betamoojw/LED-UP1-6x24V/hardware/EDA-Files/LED-UP1-4x24V/LED-UP1-4x24V.kicad_pcb

## KiCad design hardware/EDA-Files/LED-UP1-4x24V/LED-UP1-4x24V.kicad_pcb (2024-03-28)

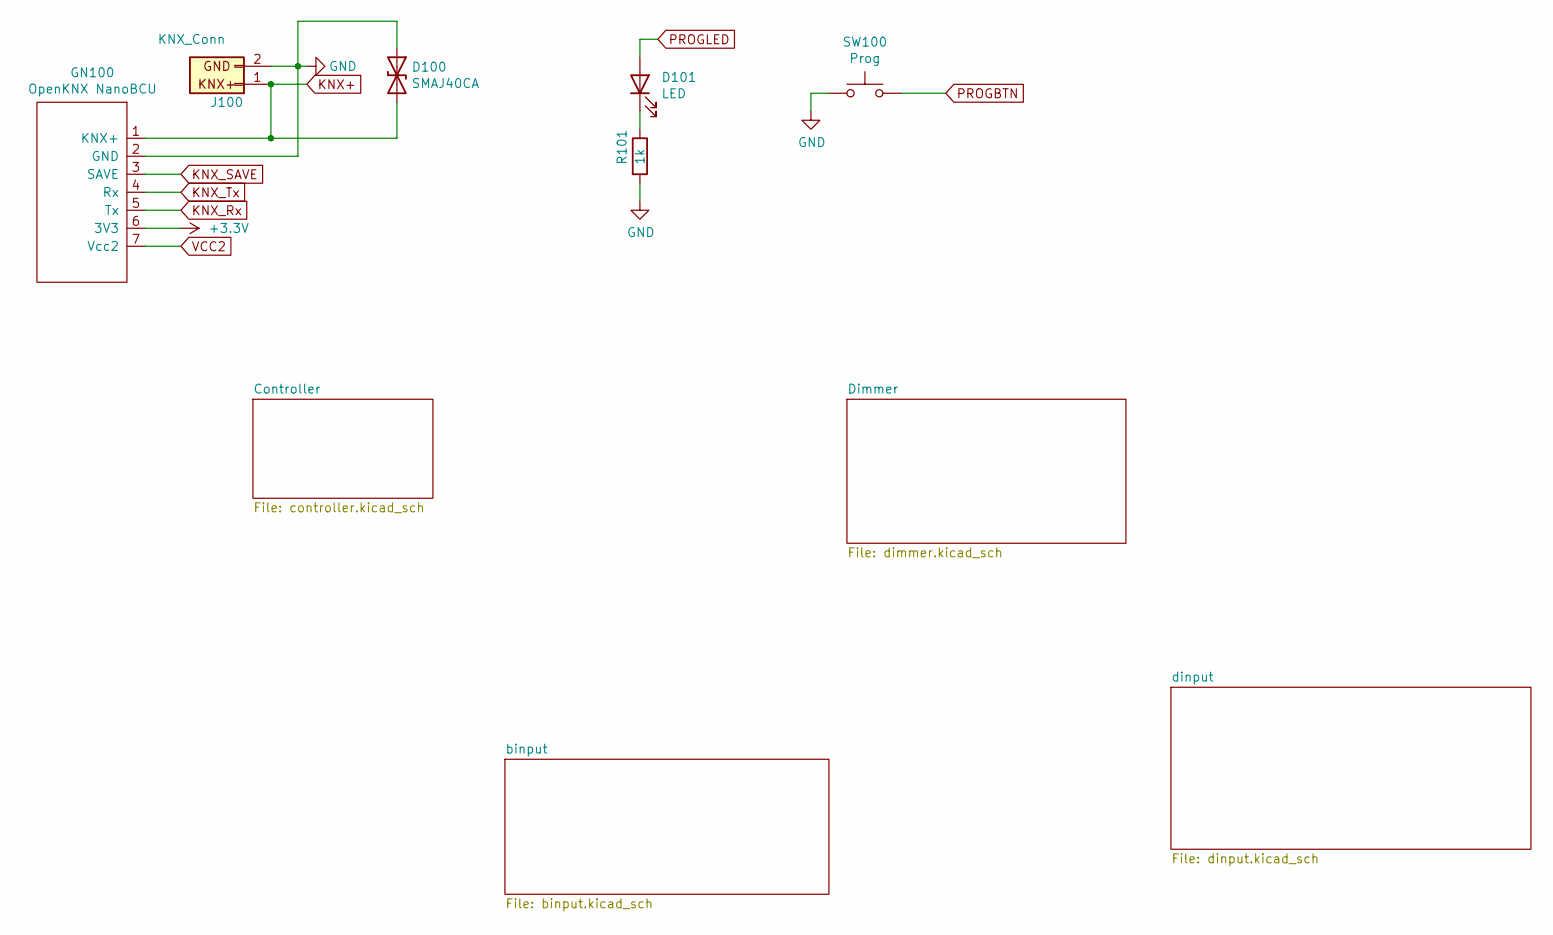
[picture p1: schematic LED-UP1-4x24V.kicad_sch]

Parts:
D100: SMAJ40CA; D_SMA; LCSC C113970
D101: LED; LED_0603_1608Metric; LCSC C2286
GN100: OpenKNX NanoBCU; NanoBCU_PinHeader_SMD_low_profile; LCSC C5160790
J100: KNX_Conn; KNX_Connector
R101: 1k; R_0402_1005Metric; LCSC C11702
SW100: Prog; C455282_SW-SMD_4P-L4.2-W3.3-P2.15-LS5.1; LCSC C455282

Connections:
+3.3V: GN100.6 (3V3); also elsewhere on the board
GND: D100.1 (A1), GN100.2 (GND), J100.2, R101.2, SW100.1; also elsewhere on the board
KNX+: D100.2 (A2), GN100.1 (KNX+), J100.1
KNX_Rx: GN100.5 (Tx); also elsewhere on the board
KNX_SAVE: GN100.3 (SAVE); also elsewhere on the board
KNX_Tx: GN100.4 (Rx); also elsewhere on the board
unnamed: D101.1 (K), R101.1
PROGBTN: SW100.2; also elsewhere on the board
PROGLED: D101.2 (A); also elsewhere on the board
VCC2: GN100.7 (Vcc2)

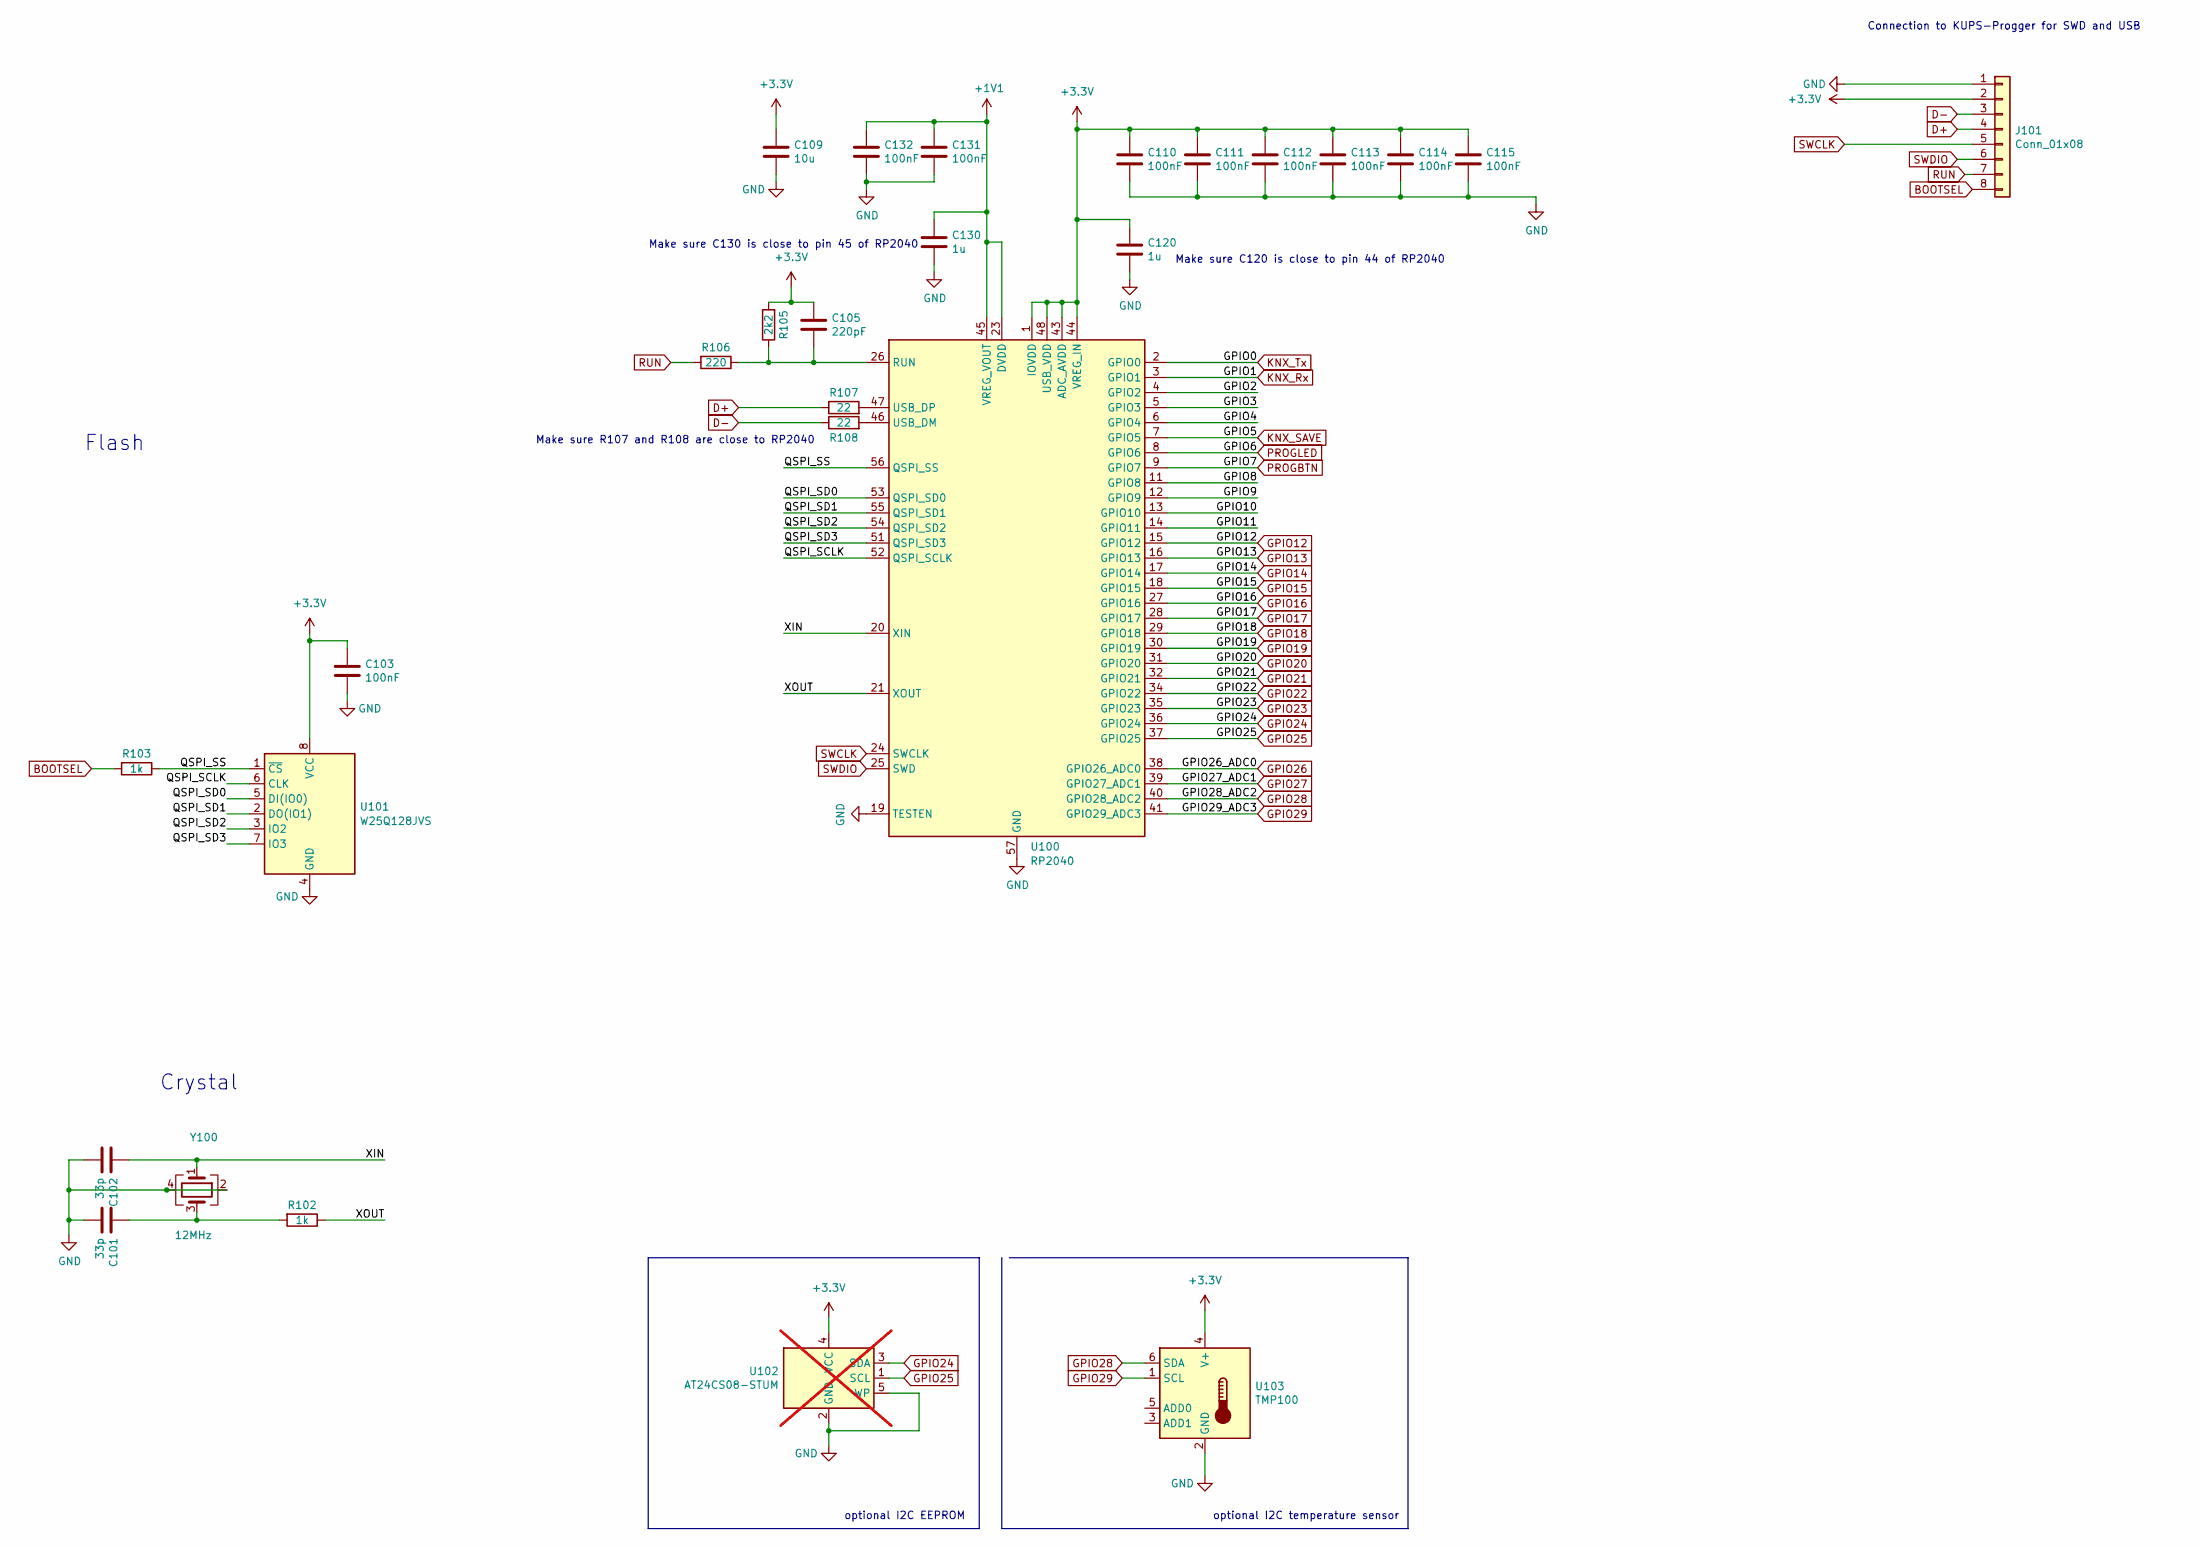
[picture p2: schematic controller.kicad_sch, LED-UP1-4x24V]

Parts:
C101, C102: 33p; C_0402_1005Metric; LCSC C1562
C103, C110, C111, C112, C113, C114, C115, C131, C132: 100nF; C_0402_1005Metric; LCSC C307331
C105: 220pF; C_0402_1005Metric; LCSC C1530
C109: 10u; C_0805_2012Metric; LCSC C15850
C120, C130: 1u; C_0402_1005Metric; LCSC C52923
J101: Conn_01x08; PinHeader_1x08_P1.27mm_Vertical; LCSC C2337
R102, R103: 1k; C_0402_1005Metric; LCSC C11702
R105: 2k2; C_0402_1005Metric; LCSC C25879
R106: 220; R_0402_1005Metric; LCSC C25091
R107, R108: 22; C_0402_1005Metric; LCSC C25092
U100: RP2040; QFN-56-1EP_7x7mm_P0.4mm_EP3.2x3.2mm; LCSC C2040
U101: W25Q128JVS; SOIC-8_5.275x5.275mm_P1.27mm; LCSC C97521
U102: AT24CS08-STUM; SOT-23-5; LCSC C232875; not fitted
U103: TMP100; SOT-23-6; LCSC C31810
Y100: 12MHz; Crystal_SMD_3225-4Pin_3.2x2.5mm; LCSC C9002

Connections:
+1V1: C130.1, C131.1, C132.1, U100.23 (DVDD), U100.45 (VREG_VOUT), U100.50 (DVDD)
+3.3V: C103.1, C105.1, C109.1, C110.1, C111.1, C112.1, C113.1, C114.1, C115.1, C120.1, J101.2, R105.2, U100.1 (IOVDD), U100.10 (IOVDD), U100.22 (IOVDD), U100.33 (IOVDD), U100.42 (IOVDD), U100.43 (ADC_AVDD), U100.44 (VREG_IN), U100.48 (USB_VDD), U100.49 (IOVDD), U101.8 (VCC), U102.4 (VCC), U103.4 (V+); also elsewhere on the board
/Controller/GPIO2: U100.4 (GPIO2)
/Controller/GPIO3: U100.5 (GPIO3)
/Controller/GPIO4: U100.6 (GPIO4)
/Controller/GPIO8: U100.11 (GPIO8)
/Controller/GPIO9: U100.12 (GPIO9)
/Controller/GPIO10: U100.13 (GPIO10)
/Controller/GPIO11: U100.14 (GPIO11)
/Controller/QSPI_SCLK: U100.52 (QSPI_SCLK), U101.6 (CLK)
/Controller/QSPI_SD0: U100.53 (QSPI_SD0), U101.5 (DI(IO0))
/Controller/QSPI_SD1: U100.55 (QSPI_SD1), U101.2 (DO(IO1))
/Controller/QSPI_SD2: U100.54 (QSPI_SD2), U101.3 (IO2)
/Controller/QSPI_SD3: U100.51 (QSPI_SD3), U101.7 (IO3)
/Controller/QSPI_SS: R103.1, U100.56 (QSPI_SS), U101.1 (~CS)
/Controller/XIN: C102.1, U100.20 (XIN), Y100.1
/Controller/XOUT: R102.1, U100.21 (XOUT)
BOOTSEL: J101.8, R103.2
D+: J101.4, R107.1
D-: J101.3, R108.1
GND: C101.2, C102.2, C103.2, C109.2, C110.2, C111.2, C112.2, C113.2, C114.2, C115.2, C120.2, C130.2, C131.2, C132.2, J101.1, U100.19 (TESTEN), U100.57 (GND), U101.4 (GND), U102.2 (GND), U102.5 (WP), U103.2 (GND), Y100.2, Y100.4; also elsewhere on the board
GPIO12: U100.15 (GPIO12)
GPIO13: U100.16 (GPIO13); also elsewhere on the board
GPIO14: U100.17 (GPIO14); also elsewhere on the board
GPIO15: U100.18 (GPIO15); also elsewhere on the board
GPIO16: U100.27 (GPIO16)
GPIO17: U100.28 (GPIO17); also elsewhere on the board
GPIO18: U100.29 (GPIO18); also elsewhere on the board
GPIO19: U100.30 (GPIO19)
GPIO20: U100.31 (GPIO20); also elsewhere on the board
GPIO21: U100.32 (GPIO21)
GPIO22: U100.34 (GPIO22); also elsewhere on the board
GPIO23: U100.35 (GPIO23)
GPIO24: U100.36 (GPIO24), U102.3 (SDA); also elsewhere on the board
GPIO25: U100.37 (GPIO25), U102.1 (SCL)
GPIO26: U100.38 (GPIO26_ADC0); also elsewhere on the board
GPIO27: U100.39 (GPIO27_ADC1); also elsewhere on the board
GPIO28: U100.40 (GPIO28_ADC2), U103.6 (SDA)
GPIO29: U100.41 (GPIO29_ADC3), U103.1 (SCL)
KNX_Rx: U100.3 (GPIO1); also elsewhere on the board
KNX_SAVE: U100.7 (GPIO5); also elsewhere on the board
KNX_Tx: U100.2 (GPIO0); also elsewhere on the board
unnamed: C101.1, R102.2, Y100.3
unnamed: C105.2, R105.1, R106.1, U100.26 (RUN)
unnamed: R108.2, U100.46 (USB_DM)
unnamed: R107.2, U100.47 (USB_DP)
PROGBTN: U100.9 (GPIO7); also elsewhere on the board
PROGLED: U100.8 (GPIO6); also elsewhere on the board
RUN: J101.7, R106.2
SWCLK: J101.5, U100.24 (SWCLK)
SWDIO: J101.6, U100.25 (SWD)

Notes on the sheet:
Make sure C130 is close to pin 45 of RP2040
optional I2C temperature sensor
Flash
optional I2C EEPROM
Crystal
Connection to KUPS-Progger for SWD and USB
Make sure C120 is close to pin 44 of RP2040
Make sure R107 and R108 are close to RP2040

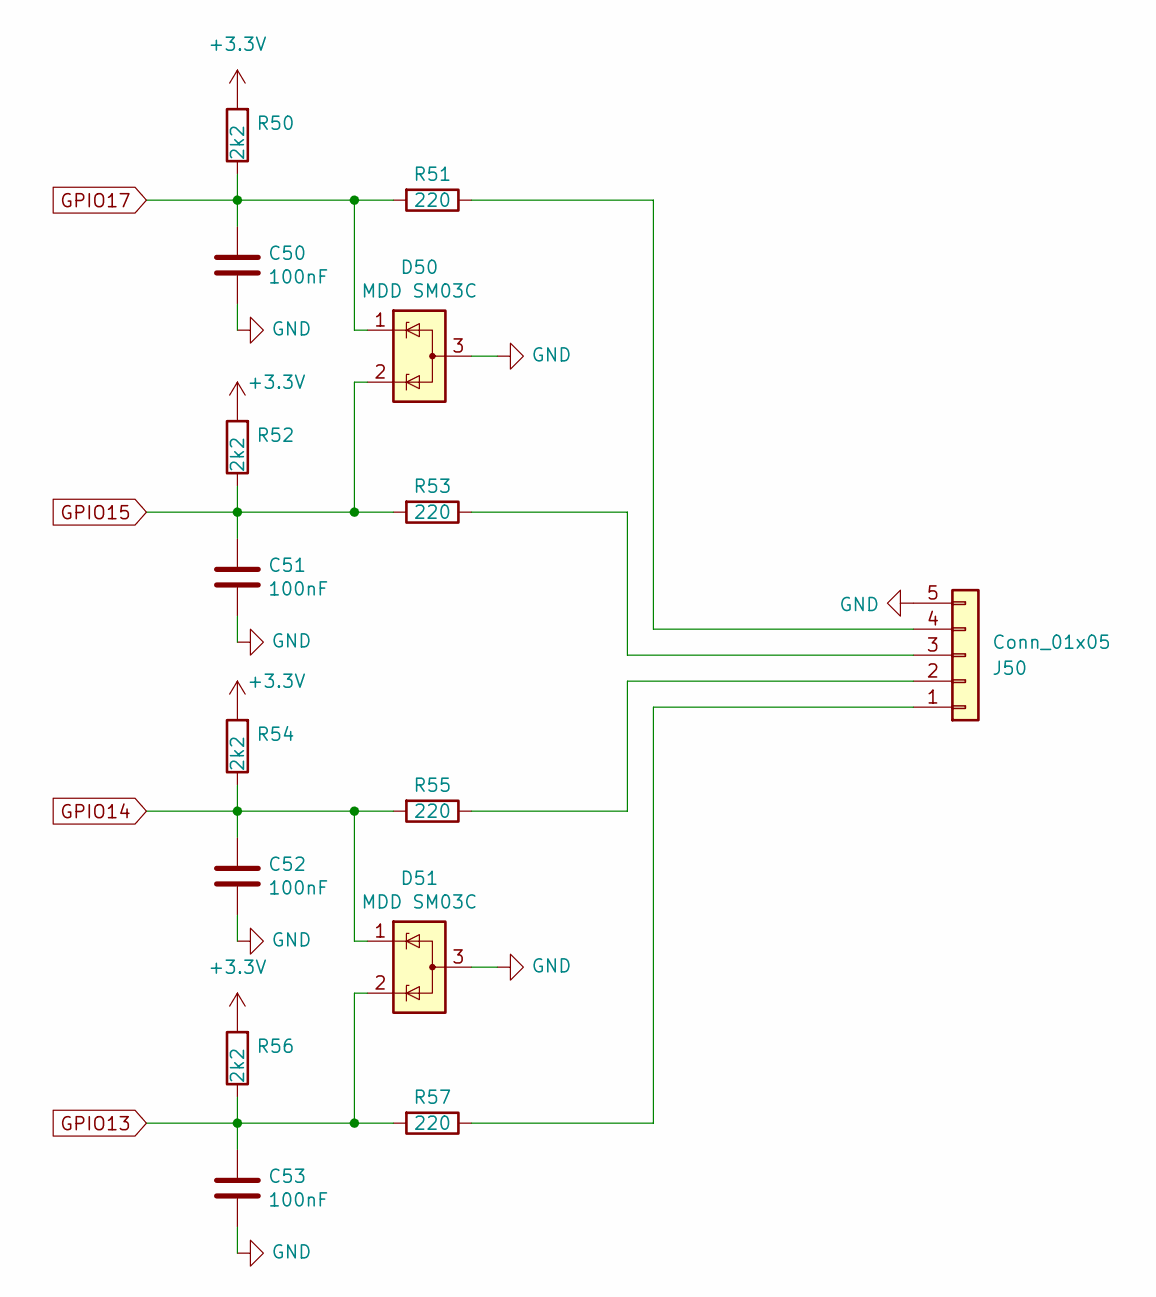
[picture p3: schematic binput.kicad_sch]

Parts:
C50, C51, C52, C53: 100nF; C_0402_1005Metric; LCSC C307331
D50, D51: MDD SM03C; SOT-23; LCSC C502553
J50: Conn_01x05; Cixi_Kefa_KF128-2.54-5p; LCSC C474923
R50, R52, R54, R56: 2k2; R_0402_1005Metric; LCSC C25879
R51, R53, R55, R57: 220; R_0402_1005Metric; LCSC C25091

Connections:
+3.3V: R50.2, R52.2, R54.2, R56.2; also elsewhere on the board
GND: C50.2, C51.2, C52.2, C53.2, D50.3 (A), D51.3 (A), J50.5; also elsewhere on the board
GPIO13: C53.1, D51.2 (K), R56.1, R57.2; also elsewhere on the board
GPIO14: C52.1, D51.1 (K), R54.1, R55.2; also elsewhere on the board
GPIO15: C51.1, D50.2 (K), R52.1, R53.2; also elsewhere on the board
GPIO17: C50.1, D50.1 (K), R50.1, R51.2; also elsewhere on the board
unnamed: J50.1, R57.1
unnamed: J50.2, R55.1
unnamed: J50.3, R53.1
unnamed: J50.4, R51.1

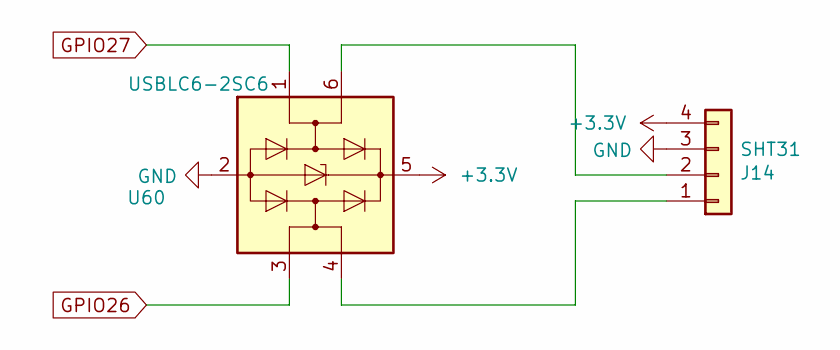
[picture p4: schematic dinput.kicad_sch]

Parts:
J14: SHT31; Cixi_Kefa_KF128-2.54-4p; LCSC C474922
U60: USBLC6-2SC6; SOT-23-6; LCSC C2827654

Connections:
+3.3V: U60.5 (VBUS); also elsewhere on the board
GND: U60.2 (GND); also elsewhere on the board
GPIO26: U60.3 (I/O2); also elsewhere on the board
GPIO27: U60.1 (I/O1); also elsewhere on the board
unnamed 55: U60.4 (I/O2); also elsewhere on the board
unnamed 56: U60.6 (I/O1); also elsewhere on the board

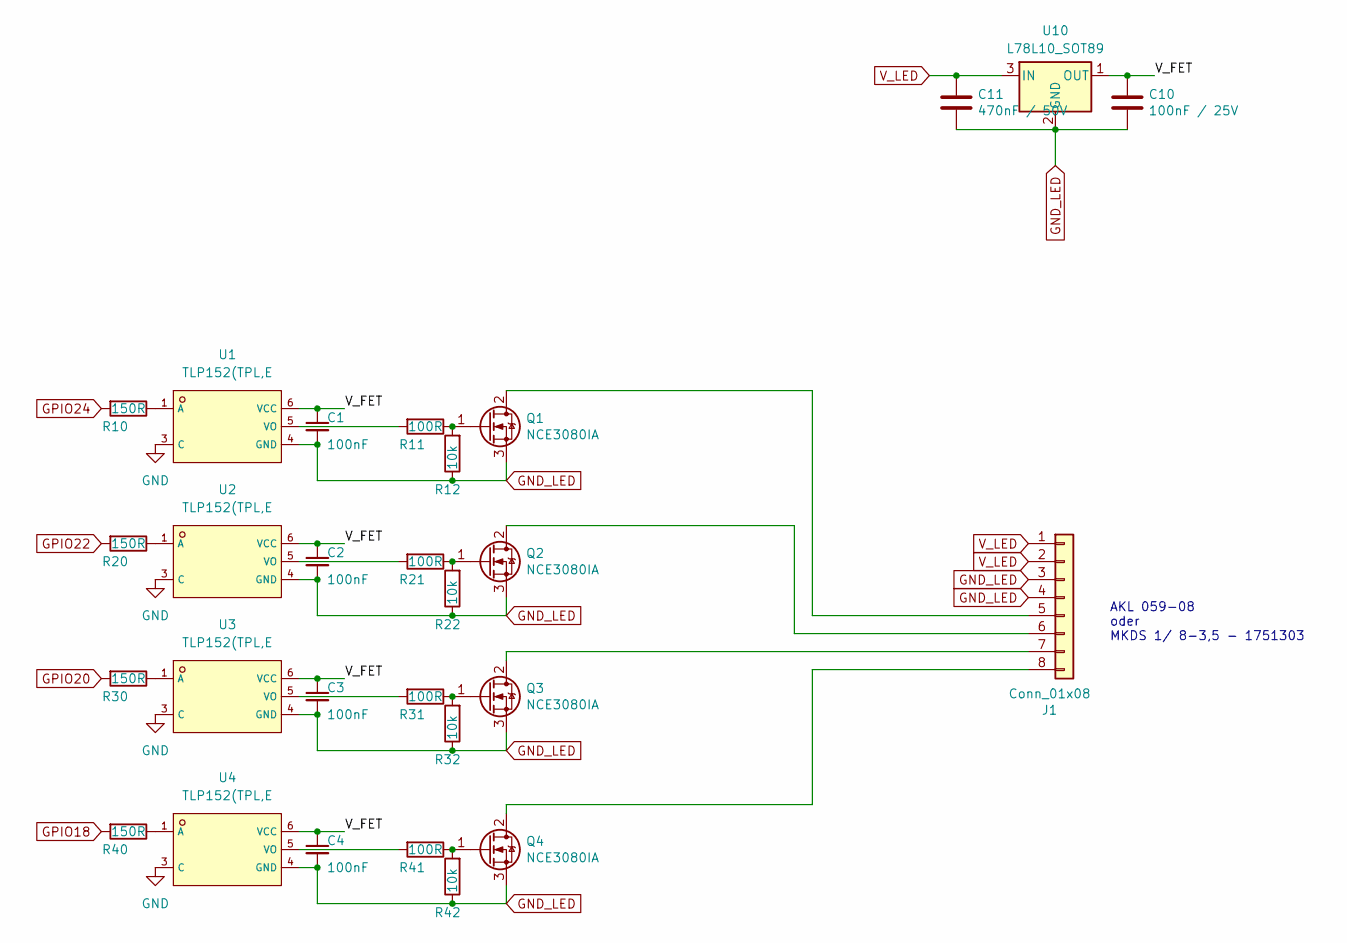
[picture p5: schematic dimmer.kicad_sch, LED-UP1-4x24V]

Parts:
C1, C2, C3, C4: 100nF; C_0402_1005Metric; LCSC C307331
C10: 100nF / 25V; C_0805_2012Metric; LCSC C49678
C11: 470nF / 50V; C_0805_2012Metric; LCSC C13967
J1: Conn_01x08; PhoenixContact_MKDS_1,5_8-G-3.5_1x08_P3.5mm_Horizontal; LCSC C5184954
Q1, Q2, Q3, Q4: NCE3080IA; TO-251-3_Vertical_lowprofile; LCSC C326369
R10, R20, R30, R40: 150R; R_0603_1608Metric; LCSC C22808
R11, R21, R31, R41: 100R; R_0402_1005Metric; LCSC C25076
R12, R22, R32, R42: 10k; R_0402_1005Metric; LCSC C25744
U1, U2, U3, U4: TLP152(TPL,E; OPTO-SMD_SO-5_L4.6-W3.7-P1.27-BR; LCSC C150122
U10: L78L10_SOT89; SOT-89-3; LCSC C75500

Connections:
/Dimmer/V_FET: C1.1, C2.1, C3.1, C4.1, C10.1, U1.6 (VCC), U2.6 (VCC), U3.6 (VCC), U4.6 (VCC), U10.1 (OUT)
GND: U1.3 (C), U2.3 (C), U3.3 (C), U4.3 (C); also elsewhere on the board
GND_LED: C1.2, C2.2, C3.2, C4.2, C10.2, C11.2, J1.3, J1.4, Q1.3 (S), Q2.3 (S), Q3.3 (S), Q4.3 (S), R12.1, R22.1, R32.1, R42.1, U1.4 (GND), U2.4 (GND), U3.4 (GND), U4.4 (GND), U10.2 (GND)
GPIO18: R40.2; also elsewhere on the board
GPIO20: R30.2; also elsewhere on the board
GPIO22: R20.2; also elsewhere on the board
GPIO24: R10.2; also elsewhere on the board
unnamed: J1.5, Q1.2 (D)
unnamed: J1.6, Q2.2 (D)
unnamed: J1.7, Q3.2 (D)
unnamed: J1.8, Q4.2 (D)
unnamed: Q1.1 (G), R11.1, R12.2
unnamed: Q2.1 (G), R21.1, R22.2
unnamed: Q3.1 (G), R31.1, R32.2
unnamed: Q4.1 (G), R41.1, R42.2
unnamed: R10.1, U1.1 (A)
unnamed: R11.2, U1.5 (VO)
unnamed: R20.1, U2.1 (A)
unnamed: R21.2, U2.5 (VO)
unnamed: R30.1, U3.1 (A)
unnamed: R31.2, U3.5 (VO)
unnamed: R40.1, U4.1 (A)
unnamed: R41.2, U4.5 (VO)
V_LED: C11.1, J1.1, J1.2, U10.3 (IN)

Notes on the sheet:
AKL 059-08 oder MKDS 1/ 8-3,5 - 1751303

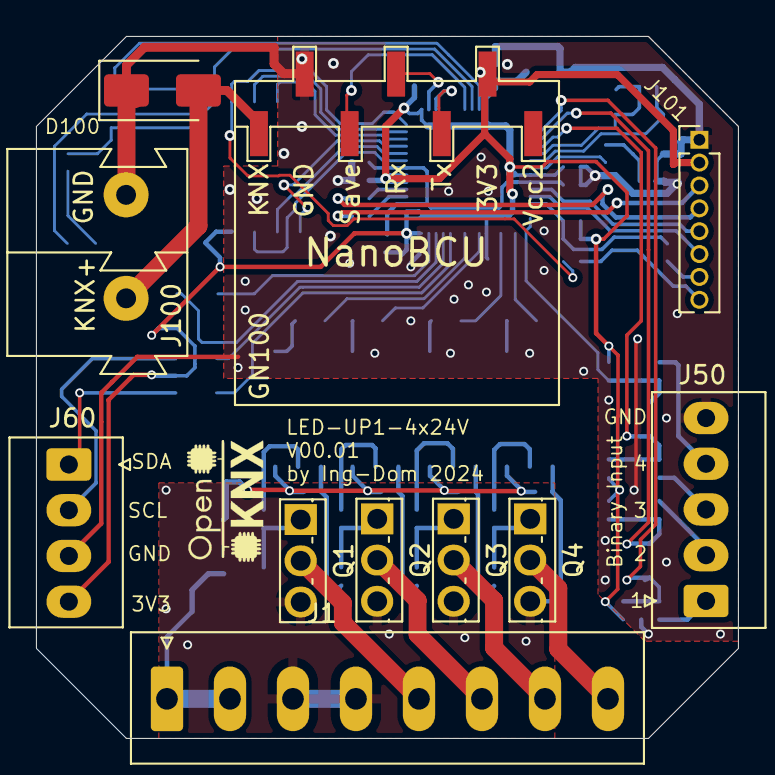
[picture p6: board LED-UP1-4x24V.kicad_pcb from above]

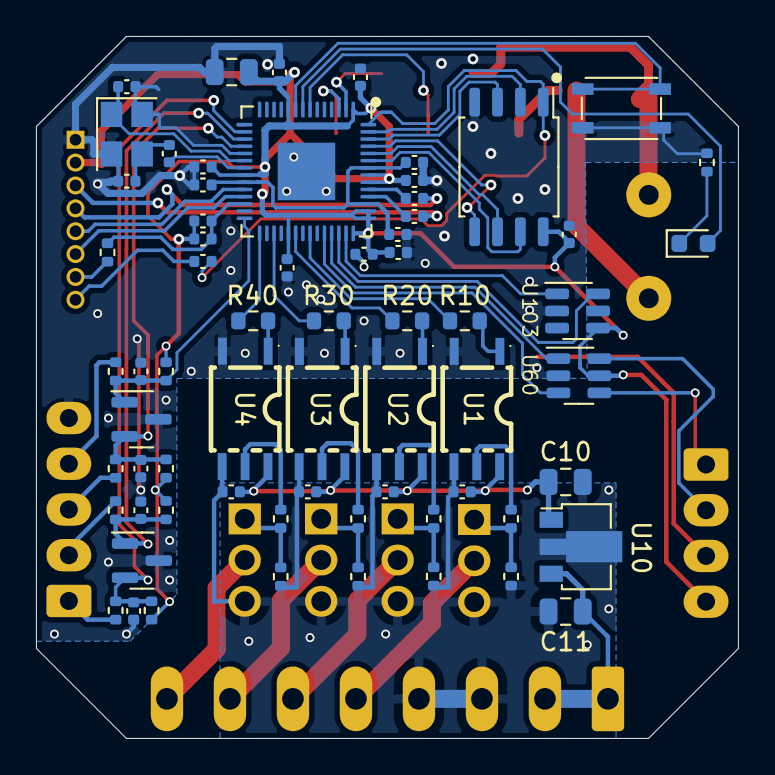
[picture p7: board LED-UP1-4x24V.kicad_pcb from below]

Board: 2 copper layers, 39.0 x 39.0 mm, 77 parts (66 on the bottom side), 65 nets.

Other parts of the board:
J60: SHT31; Cixi_Kefa_KF128-2.54-4p

Their connections:
+3.3V: J60.4; also elsewhere on the board
GND: J60.3; also elsewhere on the board
unnamed 55: J60.1; also elsewhere on the board
unnamed 56: J60.2; also elsewhere on the board
